bryanpinos/alorair-hd90-esphome/hd90_cradle_explode.png

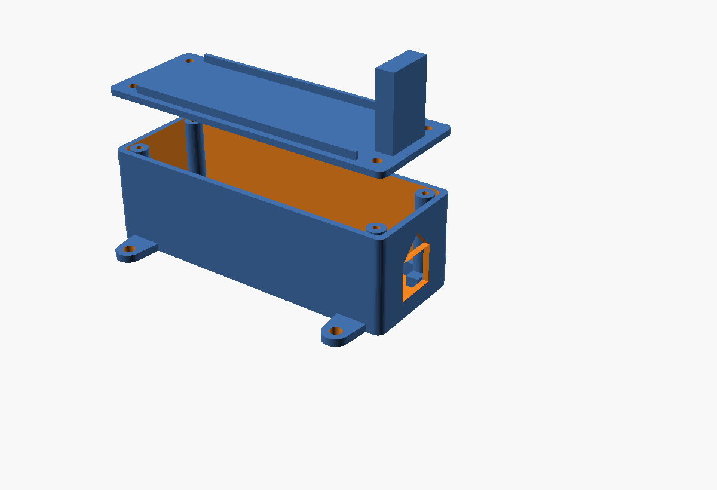
hd90_cradle_explode.png
