bryanpinos/alorair-hd90-esphome/hd90_cradle_view.png

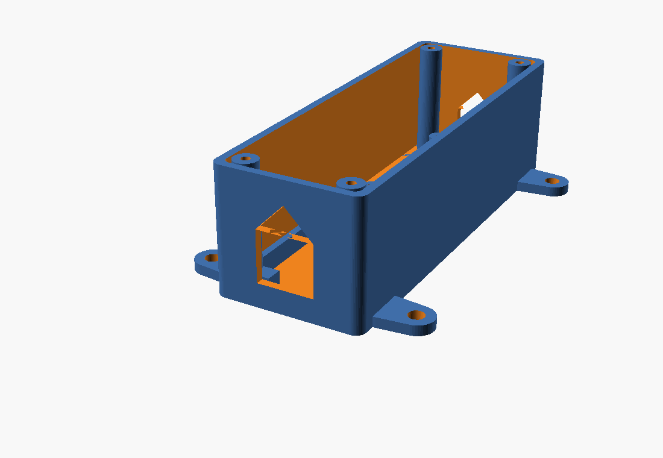
hd90_cradle_view.png
