bryanpinos/alorair-hd90-esphome/hd90_enclosure_preview.png

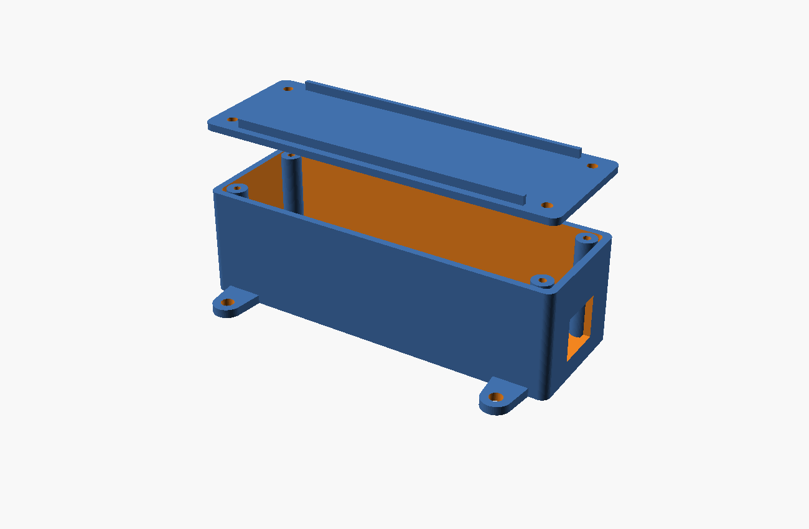
hd90_enclosure_preview.png
