bryanpinos/alorair-hd90-esphome/hd90_enclosure_tray_view.png

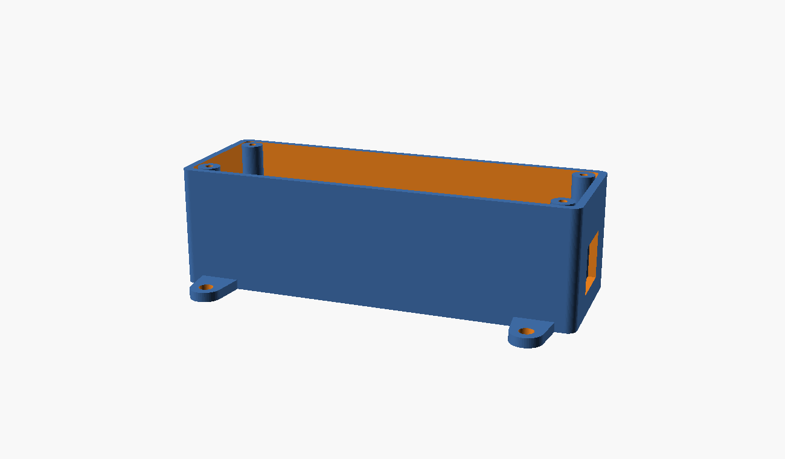
hd90_enclosure_tray_view.png
