bryanpinos/alorair-hd90-esphome/hd90_fittest_view.png

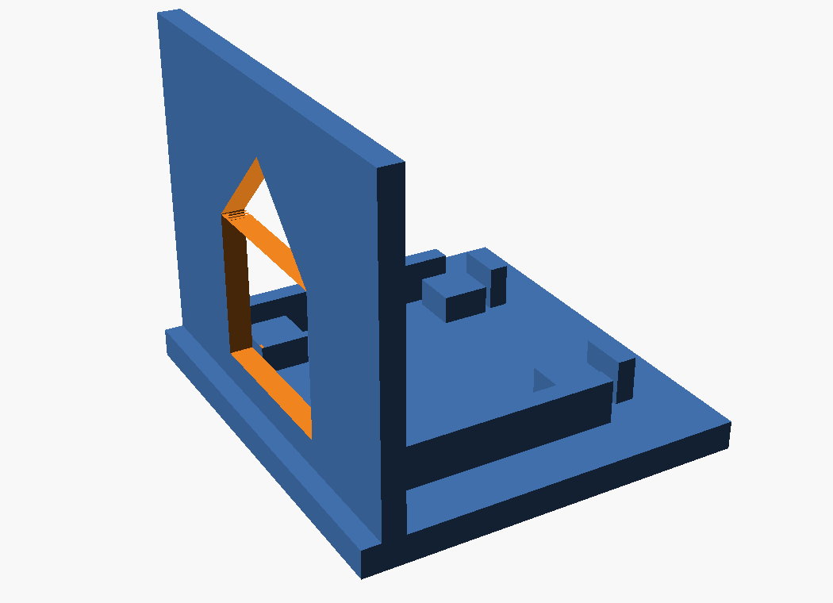
hd90_fittest_view.png
