bryanpinos/alorair-hd90-esphome/hd90_fittest_window.png

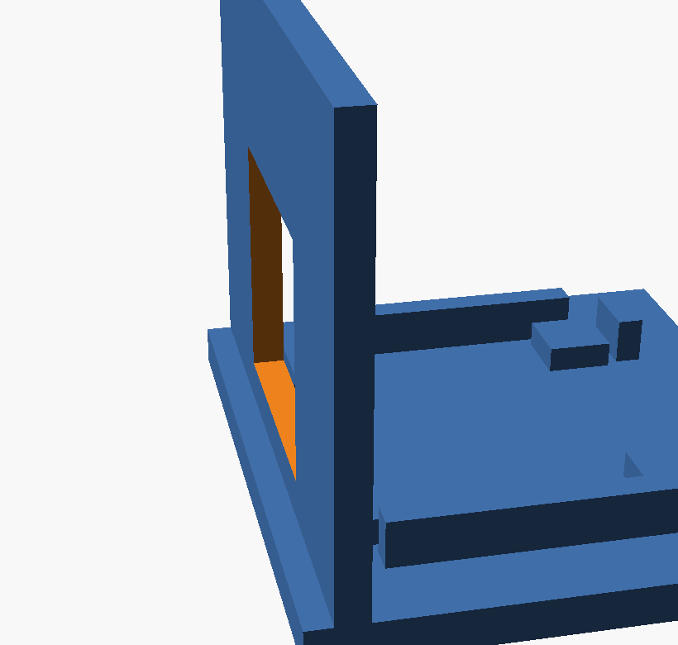
hd90_fittest_window.png
