bryanpinos/alorair-hd90-esphome/hd90_mount_preview.png

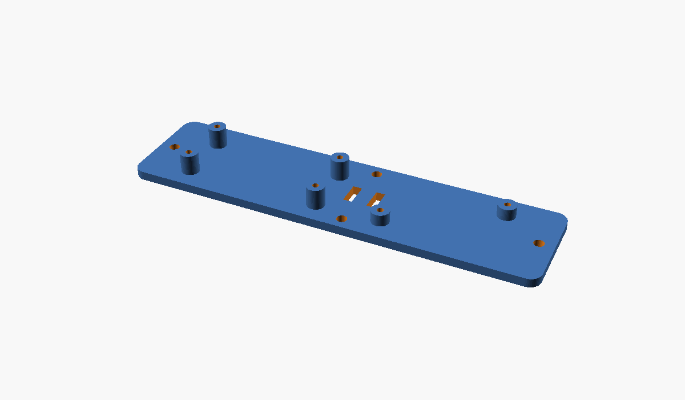
hd90_mount_preview.png
