bryanpinos/alorair-hd90-esphome/hd90_rib_section.png

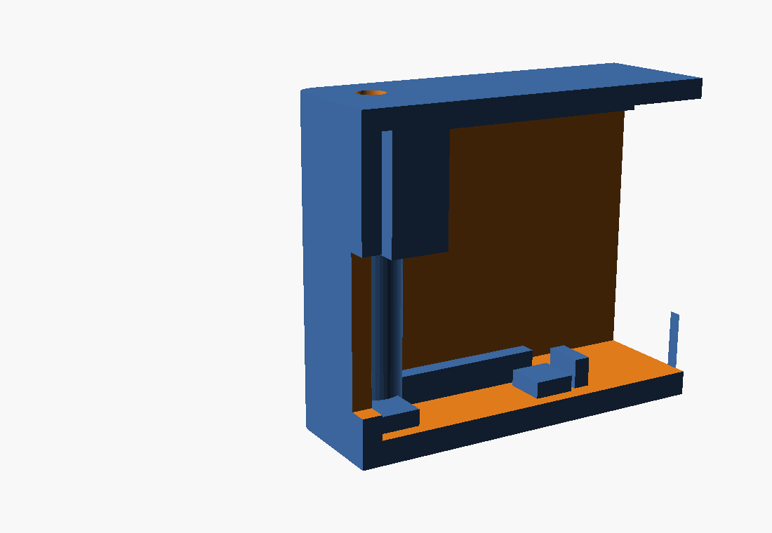
hd90_rib_section.png
