bryanpinos/alorair-hd90-esphome/hd90_rj45_window.png

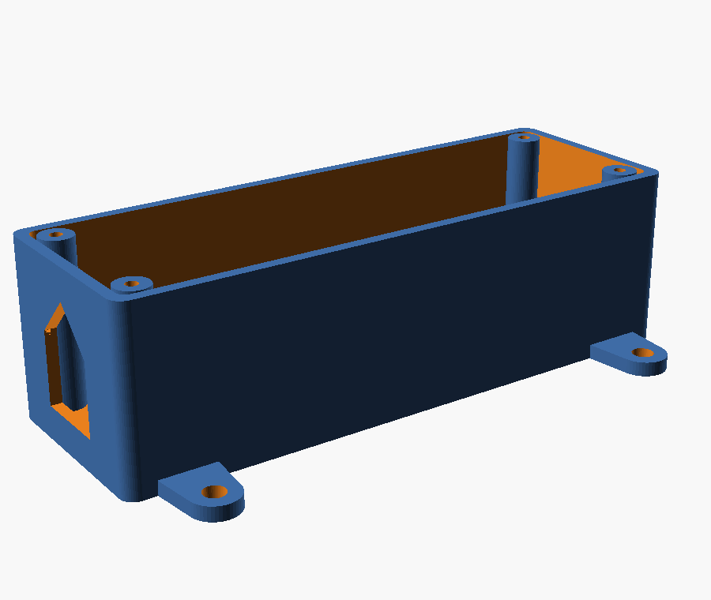
hd90_rj45_window.png
