bryanpinos/alorair-hd90-esphome/hd90_tray_gable.png

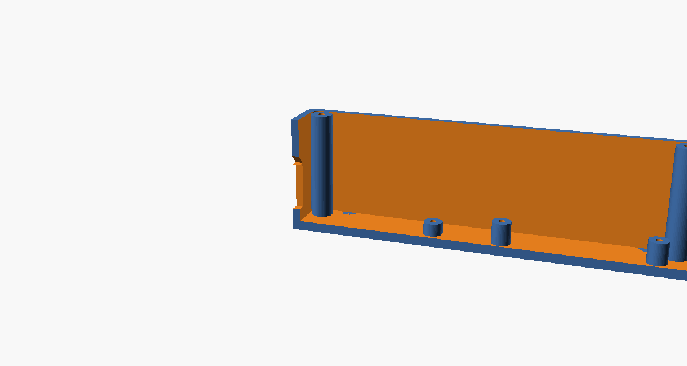
hd90_tray_gable.png
