bryanpinos/alorair-hd90-esphome/hd90_tray_section.png

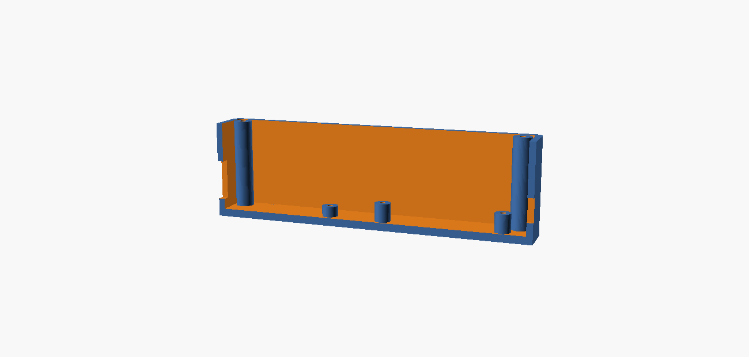
hd90_tray_section.png
