bryanpinos/alorair-hd90-esphome/hd90_tray_top.png

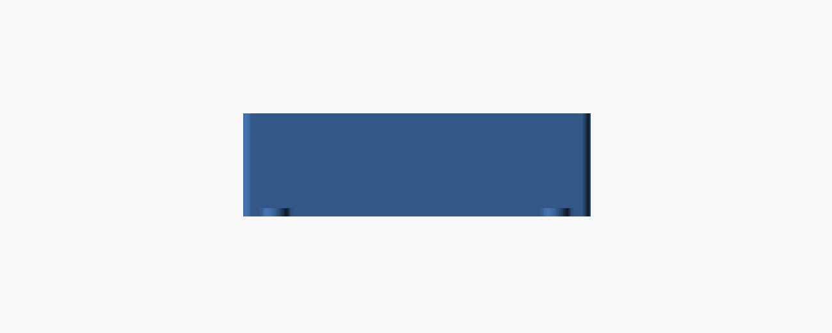
hd90_tray_top.png
