bryanpinos/alorair-hd90-esphome/hd90_tray_usbend.png

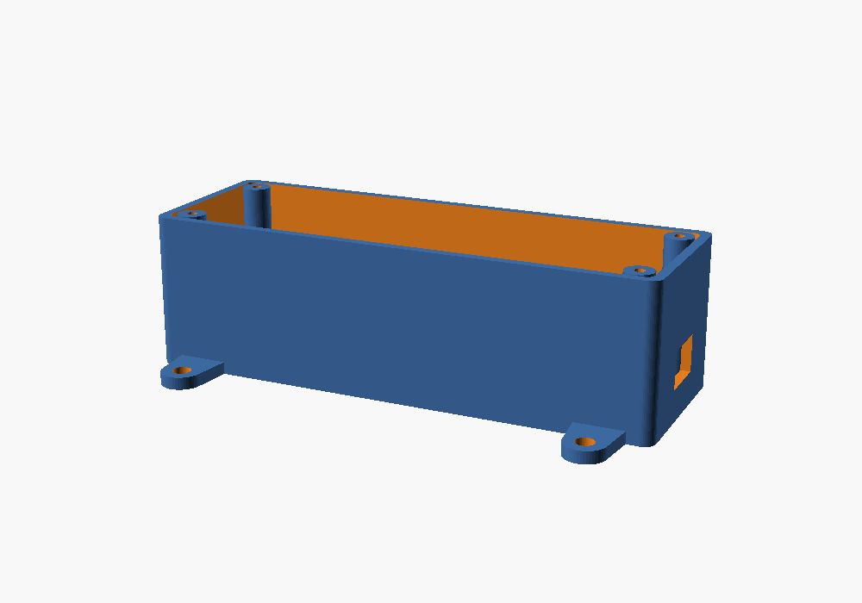
hd90_tray_usbend.png
