bryanpinos/alorair-hd90-esphome/hd90_enclosure_tray.stl

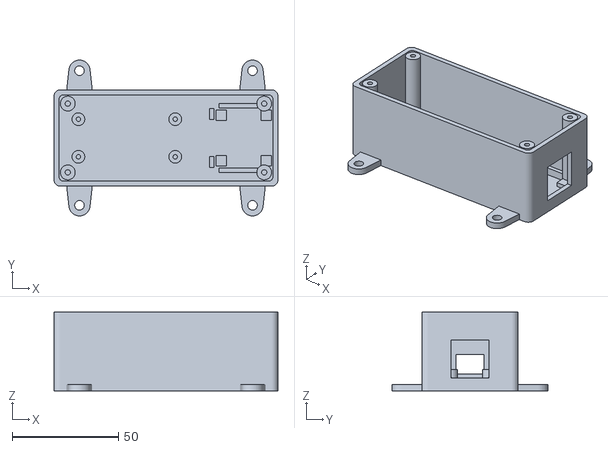
[picture p14: CAD file, 2026-07-24]
hd90_enclosure_tray.stl
105.5 x 73.4 x 37.0
