bryanpinos/alorair-hd90-esphome/hd90_mount.stl

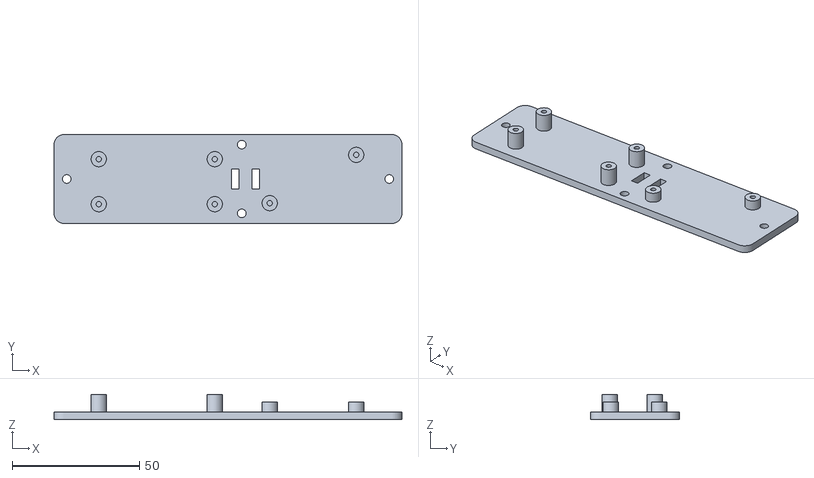
[picture p15: CAD file, 2026-07-24]
hd90_mount.stl
136.8 x 35.0 x 10.0
