bryanpinos/alorair-hd90-esphome/hd90_rj45_fittest.stl

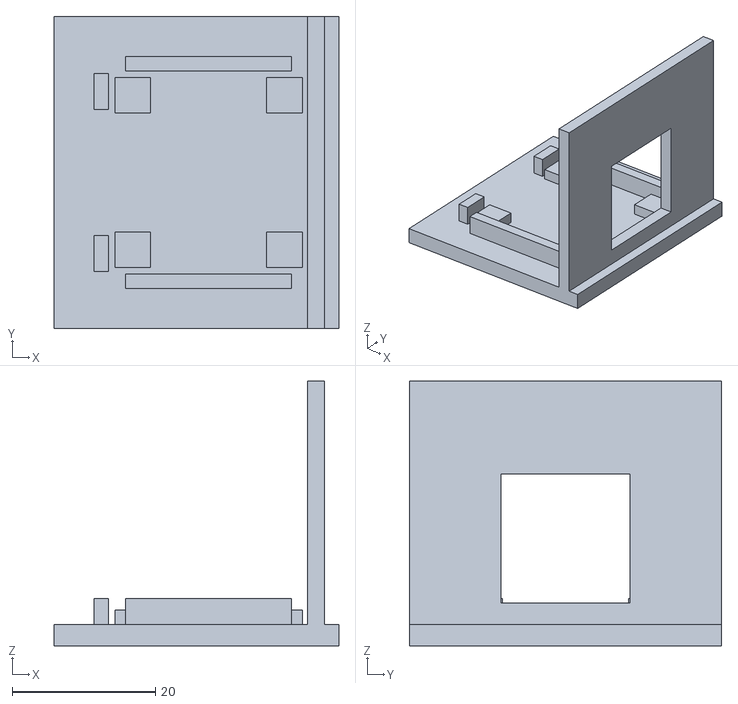
[picture p16: CAD file, 2026-07-24]
hd90_rj45_fittest.stl
39.8 x 43.6 x 37.0
