bryanpinos/alorair-hd90-esphome/hd90_enclosure_lid.stl

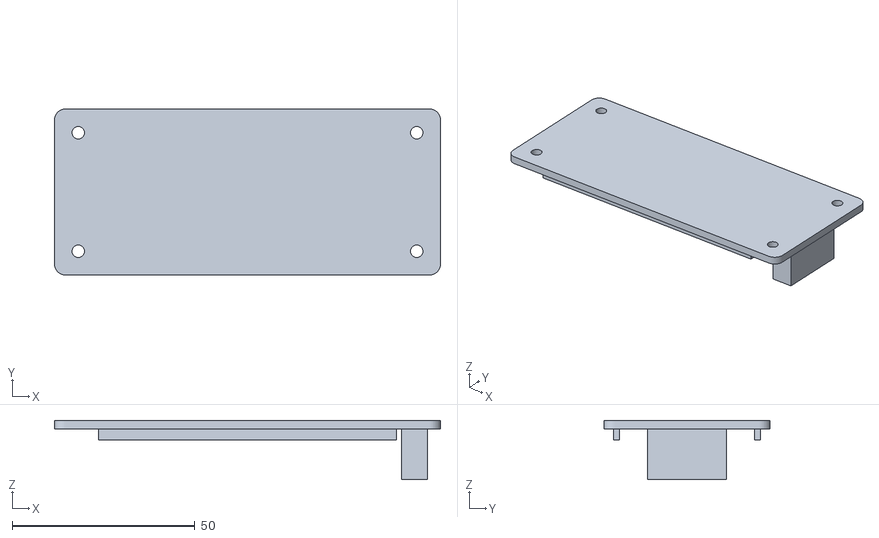
[picture p17: CAD file, 2026-07-24]
hd90_enclosure_lid.stl
105.5 x 45.4 x 16.2
