bryanpinos/alorair-hd90-esphome/(commit log)

2026-07-24 Initial commit: AlorAir HD90 ESPHome CAN controller
    ESP32 Feather V2 + CAN Bus FeatherWing controlling an AlorAir Sentinel HD90 dehumidifier over its RJ45 CAN remote port, integrated into Home Assistant via MQTT.
    - Reverse-engineered protocol (verified live): 125 kbps, poll 0x123, status + setpoint/power/continuous byte layouts
    - Phase 1 sniffer and Phase 2 production ESPHome configs
    - Parametric OpenSCAD enclosure (tray + lid + fit-test) with STLs
    - Runs entirely off the dehumidifier's own 5V remote-bus rail
    [hd90-controller-sniffer.yaml, hd90-controller.yaml, hd90_enclosure.scad, hd90_enclosure_lid.stl, hd90_enclosure_tray.stl, hd90_mount.scad, hd90_mount.stl, hd90_rj45_fittest.stl]
2026-08-31 Make the MQTT broker a secret instead of a tracked placeholder
    The broker address was a hardcoded placeholder in the tracked config, so
    every user had to edit hd90-controller.yaml in place -- which invites
    committing a private broker address back to the repo. Read it from
    secrets.yaml (already gitignored) via !secret instead, and add the key to
    secrets.yaml.example so the template stays complete.
    Prefer a DNS name over a bare IP so the broker can be repointed to another
    host without reflashing the node.
    [hd90-controller.yaml]
2026-10-17 Report the Wi-Fi BSSID
    The controller had a wifi_signal sensor but no BSSID, so it showed a blank
    access-point cell on the ESP fleet dashboard. A device silently sitting on a
    far AP is exactly the fault that is hard to see -- an APC bridge was stranded
    on the shed AP at -92 dBm / 1 Mbps before anyone noticed.
    [hd90-controller.yaml]
